LonghornEngineer/Propeller_Development_Bit_Flicker/Layout.png

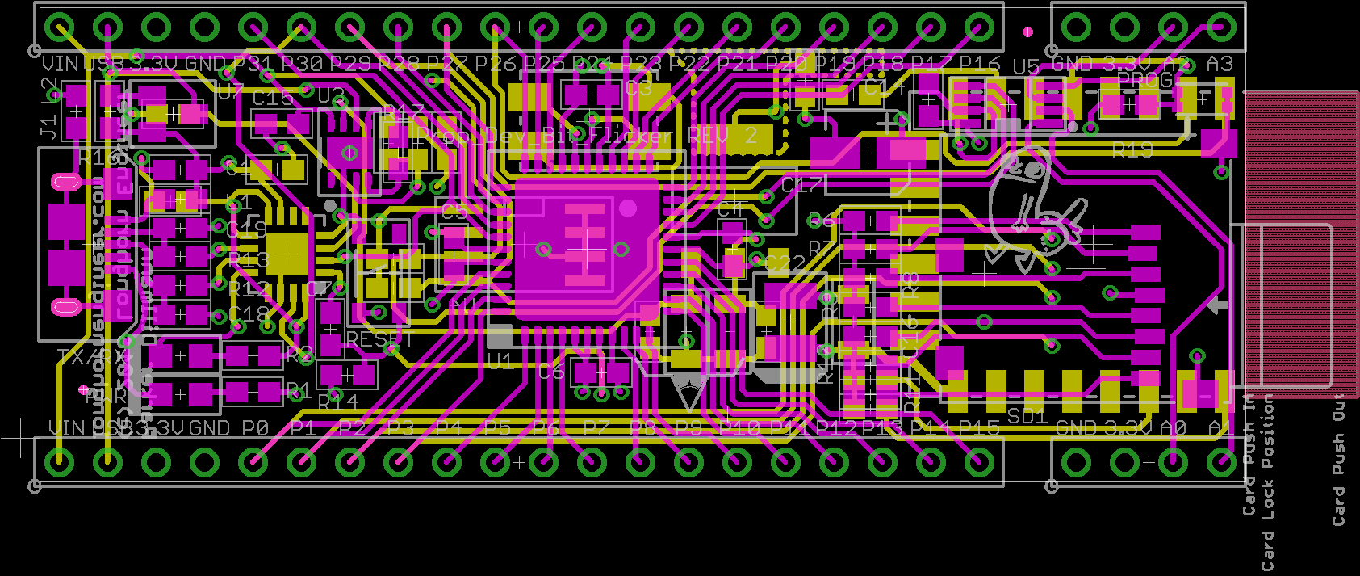
Layout.png
