LonghornEngineer/Propeller_Development_Bit_Flicker/Prop_Dev_Bit_Flicker.brd

## EAGLE design Prop_Dev_Bit_Flicker.brd (2016-04-28)

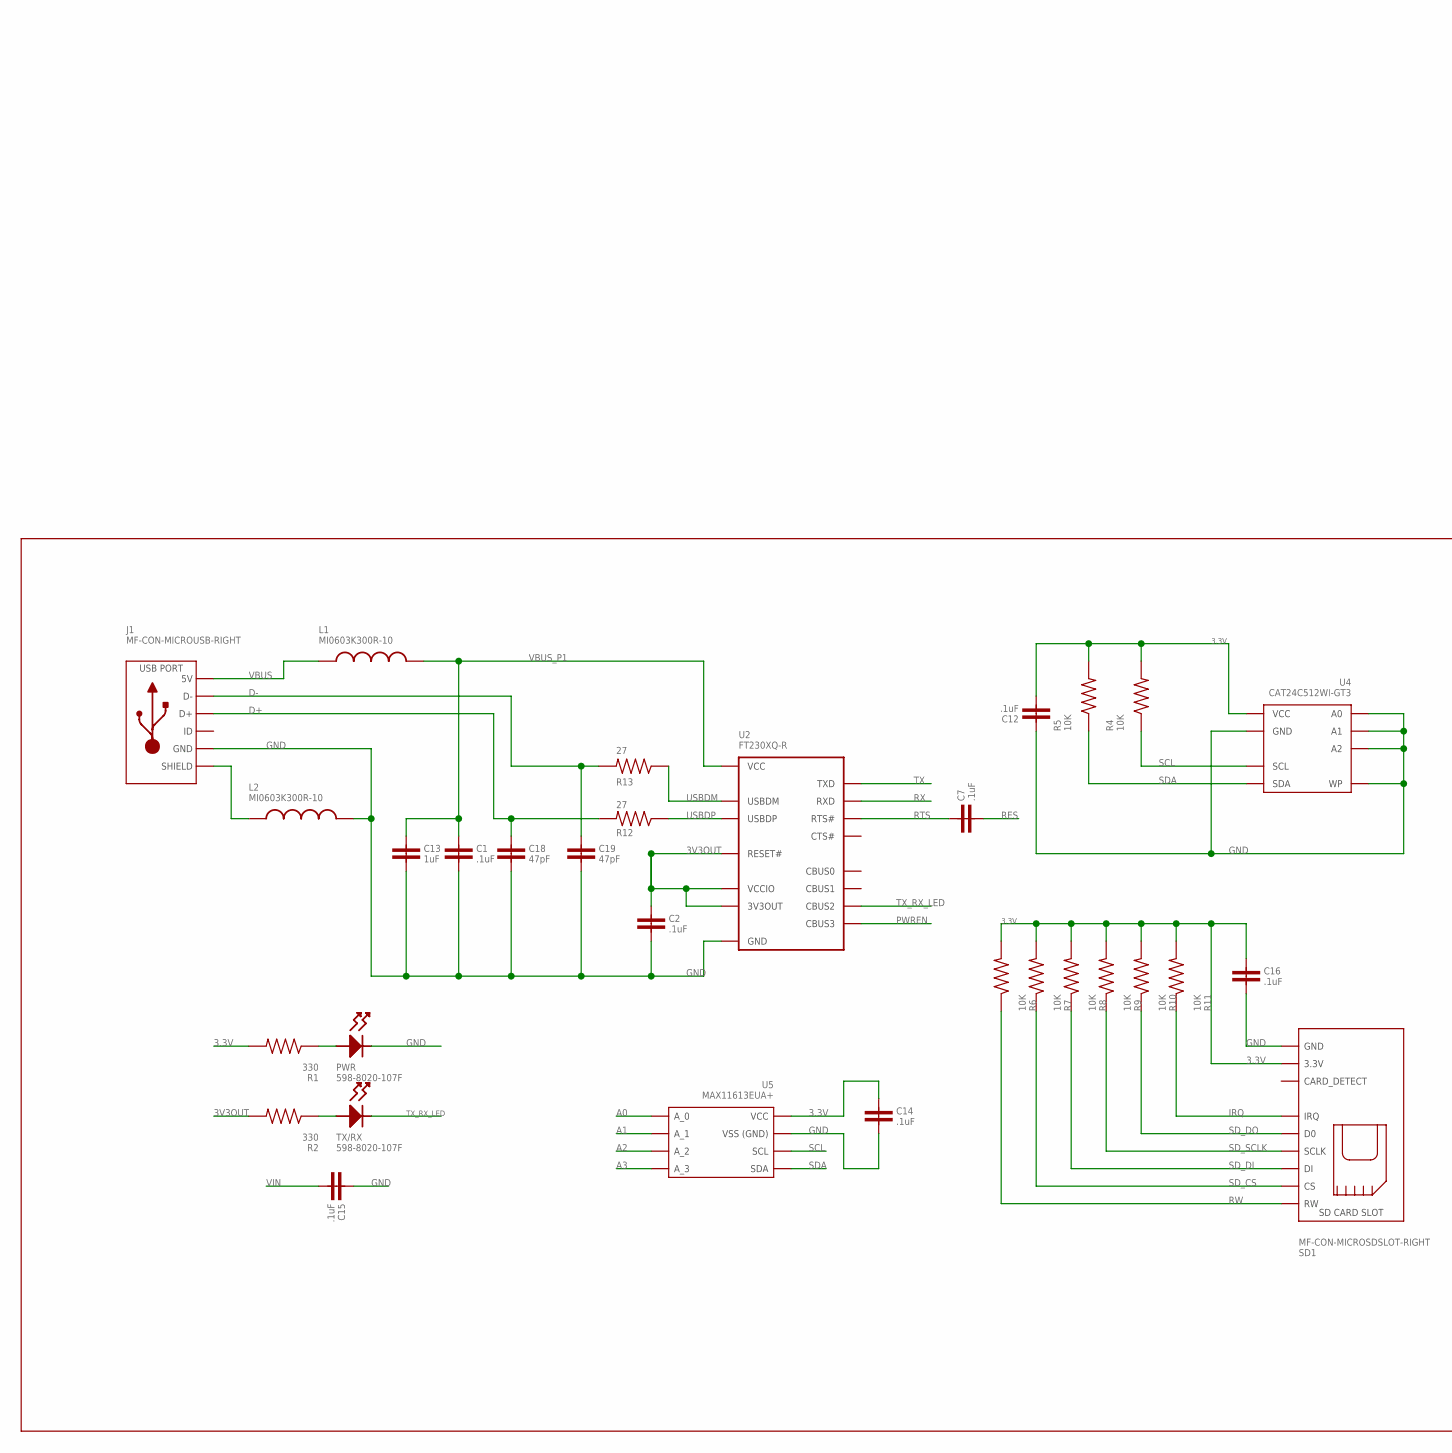
[picture p2: schematic Prop_Dev_Bit_Flicker.sch, part in row 1, column 1]

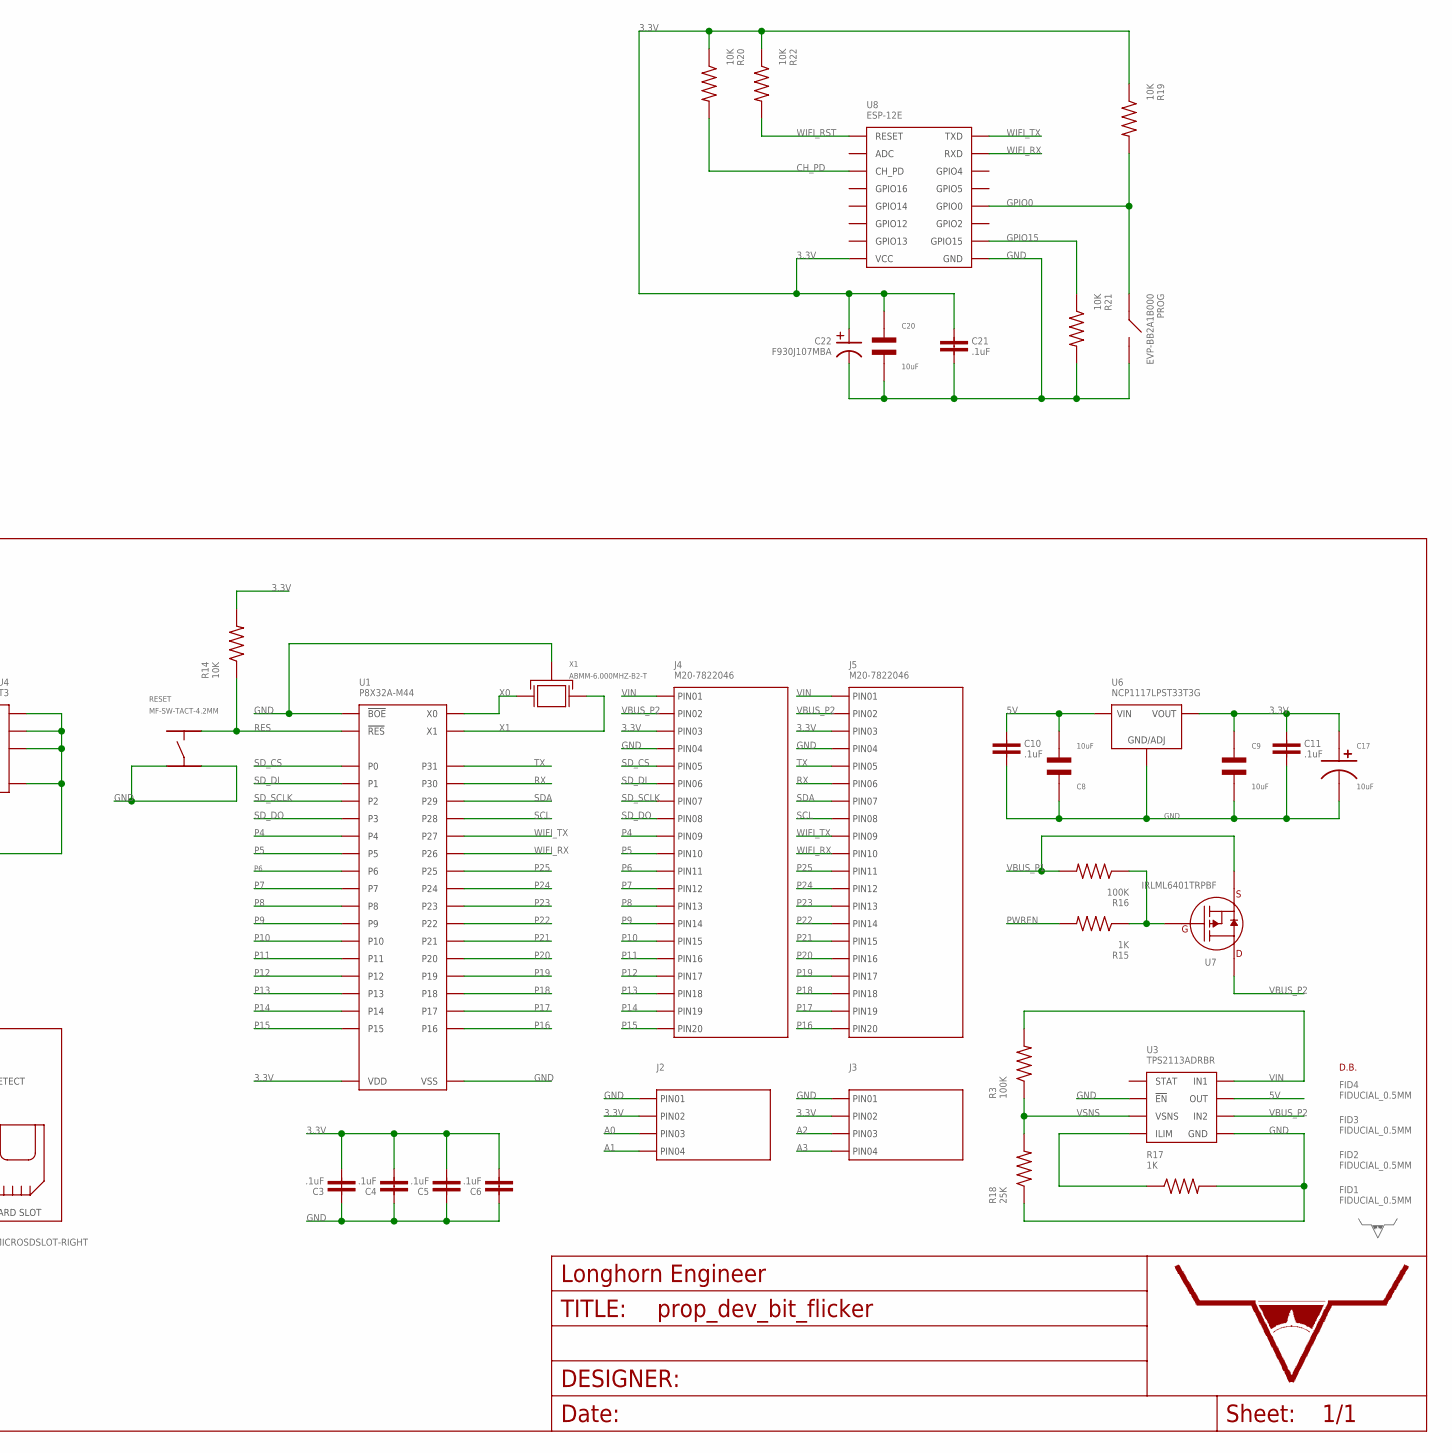
[picture p3: schematic Prop_Dev_Bit_Flicker.sch, part in row 1, column 2]

Parts:
C1, C2, C3, C4, C5, C6, C7, C10, C11, C12, C14, C15, C16, C21: .1uF; 0603
C8, C9, C20: 10uF; C1206
C13: 1uF; 0603
C17: 10uF; CP4MM
C18, C19: 47pF; 0603
C22: F930J107MBA; CASE_B
FID1, FID2, FID3, FID4: FIDUCIAL_0.5MM
J1: MF-CON-MICROUSB-RIGHT; MICROUSB-RIGHT
J2, J3: CON_01X04_2.54MM_PIN_HEADER; 2.54MM_01X04_PIN_HEADER
J4, J5: M20-7822046; 2.54MM_01X20_PIN_HEADER
L1, L2: MI0603K300R-10; 0603
PROG: EVP-BB2A1B000; EVPBB
PWR: 598-8020-107F; LED_0805
R1, R2: 330; 0603
R3, R16: 100K; 0603
R4, R5, R6, R7, R8, R9, R10, R11, R14, R19, R20, R21, R22: 10K; 0603
R12, R13: 27; 0603
R15, R17: 1K; 0603
R18: 25K; 0603
RESET: MF-SW-TACT-4.2MM; TACT4.2MM
SD1: MF-CON-MICROSDSLOT-RIGHT; MICROSDSLOT-RIGHT
TX/RX: 598-8020-107F; LED_0805
U1: P8X32A-M44; P8X32A_QFN-44
U2: FT230XQ-R; FT230X_QFN-16
U3: TPS2113ADRBR; TPS211X_SON-8
U4: CAT24C512WI-GT3; SOIC-8_W
U5: MAX11613EUA+; MAX11613_UMAX-8
U6: NCP1117LPST33T3G; SOT-223-3
U7: IRLML6401TRPBF; SOT-23-3
U8: ESP-12E
U$1: LHE_FRAME
U$2: LHE_LOGOLHE_LOGO; LHE_LOGO
U$3: DB_LOGO_SILK_SMALL; DB_SILK_SMALL
X1: ABMM-6.000MHZ-B2-T; 7MMX5MM

Connections:
3.3V: C3.2, C4.2, C5.2, C6.2, C9.P$1, C11.1, C12.2, C14.1, C16.1, C17.P$1, C20.P$1, C21.1, C22.P (POS), J2.2, J3.2, J4.3, J5.3, R1.2, R4.2, R5.2, R6.2, R7.2, R8.2, R9.2, R10.2, R11.2, R14.2, R19.1, R20.1, R22.1, SD1.PIN4 (3.3V), U1.8 (VDD), U1.18 (VDD), U1.30 (VDD), U1.40 (VDD), U4.8 (VCC), U5.P$8 (VCC), U6.P$1 (VOUT), U6.P$3 (VOUT), U8.P$8 (VCC)
3V3OUT: C2.1, R2.2, U2.1 (VCCIO), U2.8 (3V3OUT), U2.9 (RESET#)
5V: C8.P$2, C10.1, U3.7 (OUT), U6.P$4 (VIN)
A0: J2.3, U5.P$1 (A_0)
A1: J2.4, U5.P$2 (A_1)
A2: J3.3, U5.P$3 (A_2)
A3: J3.4, U5.P$4 (A_3)
CH_PD: R20.2, U8.P$3 (CH_PD)
D+: C18.1, J1.3 (D+), R12.2
D-: C19.1, J1.2 (D-), R13.2
GND: C1.2, C2.2, C3.1, C4.1, C5.1, C6.1, C8.P$1, C9.P$2, C10.2, C11.2, C12.1, C13.2, C14.2, C15.1, C16.2, C17.P$2, C18.2, C19.2, C20.P$2, C21.2, C22.N (NEG), J1.5 (GND), J2.1, J3.1, J4.4, J5.4, L2.2, PROG.P$3 (B), PROG.P$4 (B), PWR.CATHODE, R17.2, R18.1, R21.2, RESET.P$3, RESET.P$4, SD1.G0 (GND), SD1.G1 (GND), SD1.PIN6 (GND), U1.5 (VSS), U1.6 (!BOE), U1.17 (VSS), U1.27 (VSS), U1.39 (VSS), U2.3 (GND), U2.13 (GND), U2.PAD (GND), U3.2 (!EN), U3.5 (GND), U3.PAD (GND), U4.1 (A0), U4.2 (A1), U4.3 (A2), U4.4 (GND), U4.7 (WP), U5.P$7 (GND), U6.P$2 (GND/ADJ), U8.P$15 (GND), X1.P$2 (GND), X1.P$4 (GND)
GPIO0: PROG.P$1 (A), PROG.P$2 (A), R19.2, U8.P$18 (GPIO0)
GPIO15: R21.1, U8.P$16 (GPIO15)
IRQ: R11.1, SD1.PIN8 (IRQ)
unnamed: PWR.ANODE, R1.1
unnamed: R2.1, TX/RX.ANODE
unnamed: J1.S1 (SLD), J1.S2 (SLD), J1.S3 (SLD), J1.S4 (SLD), J1.S5 (SLD), J1.S6 (SLD), L2.1
unnamed: R17.1, U3.4 (ILIM)
unnamed: R15.1, R16.1, U7.1 (GATE)
P4: J4.9, U1.1 (P4)
P5: J4.10, U1.2 (P5)
P6: J4.11, U1.3 (P6)
P7: J4.12, U1.4 (P7)
P8: J4.13, U1.9 (P8)
P9: J4.14, U1.10 (P9)
P10: J4.15, U1.11 (P10)
P11: J4.16, U1.12 (P11)
P12: J4.17, U1.13 (P12)
P13: J4.18, U1.14 (P13)
P14: J4.19, U1.15 (P14)
P15: J4.20, U1.16 (P15)
P16: J5.20, U1.19 (P16)
P17: J5.19, U1.20 (P17)
P18: J5.18, U1.21 (P18)
P19: J5.17, U1.22 (P19)
P20: J5.16, U1.23 (P20)
P21: J5.15, U1.24 (P21)
P22: J5.14, U1.25 (P22)
P23: J5.13, U1.26 (P23)
P24: J5.12, U1.31 (P24)
P25: J5.11, U1.32 (P25)
PWREN: R15.2, U2.14 (CBUS3)
RES: C7.2, R14.1, RESET.P$2, U1.7 (!RES)
RTS: C7.1, U2.16 (RTS#)
RW: R6.1, SD1.PIN1 (RW)
RX: J5.6, U1.37 (P30), U2.2 (RXD)
SCL: J5.8, R4.1, U1.35 (P28), U4.6 (SCL), U5.P$5 (SCL)
SDA: J5.7, R5.1, U1.36 (P29), U4.5 (SDA), U5.P$6 (SDA)
SD_CS: J4.5, R7.1, SD1.PIN2 (CS), U1.41 (P0)
SD_DI: J4.6, R8.1, SD1.PIN3 (DI), U1.42 (P1)
SD_DO: J4.8, R10.1, SD1.PIN7 (D0), U1.44 (P3)
SD_SCLK: J4.7, R9.1, SD1.PIN5 (SCLK), U1.43 (P2)
TX: J5.5, U1.38 (P31), U2.15 (TXD)
TX_RX_LED: TX/RX.CATHODE, U2.5 (CBUS2)
USBDM: R13.1, U2.7 (USBDM)
USBDP: R12.1, U2.6 (USBDP)
VBUS: J1.1 (5V), L1.1
VBUS_P1: C1.1, C13.1, L1.2, R16.2, U2.10 (VCC), U7.2 (SOURCE)
VBUS_P2: J4.2, J5.2, U3.6 (IN2), U7.3 (DRAIN)
VIN: C15.2, J4.1, J5.1, R3.2, U3.8 (IN1)
VSNS: R3.1, R18.2, U3.3 (VSNS)
WIFI_RST: R22.2, U8.P$1 (RESET)
WIFI_RX: J5.10, U1.33 (P26), U8.P$21 (RXD)
WIFI_TX: J5.9, U1.34 (P27), U8.P$22 (TXD)
X0: U1.29 (X0), X1.P$3 (X1)
X1: U1.28 (X1), X1.P$1 (X0)

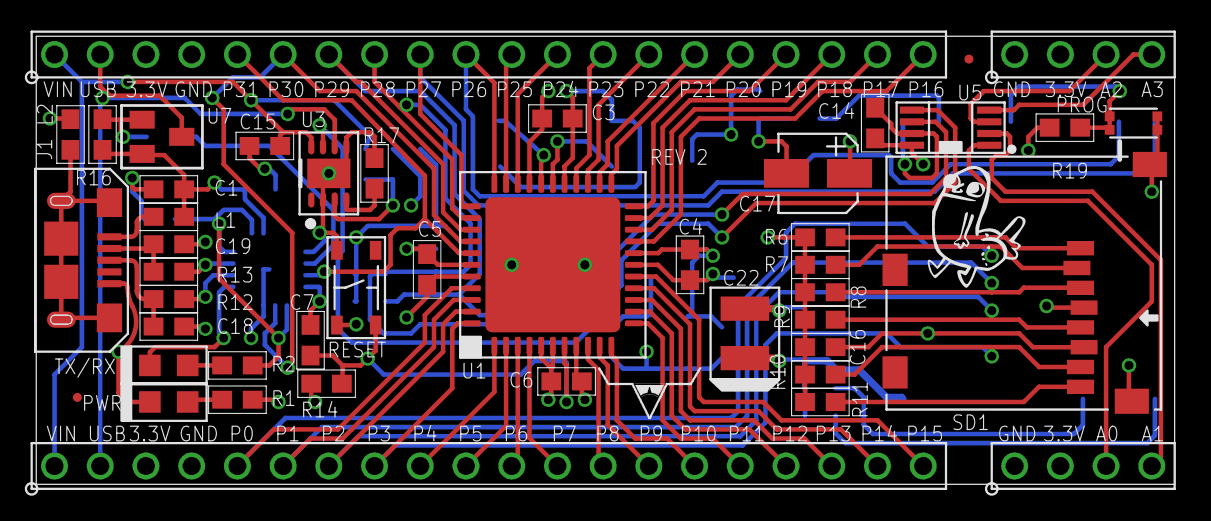
[picture p4: board Prop_Dev_Bit_Flicker.brd from above]

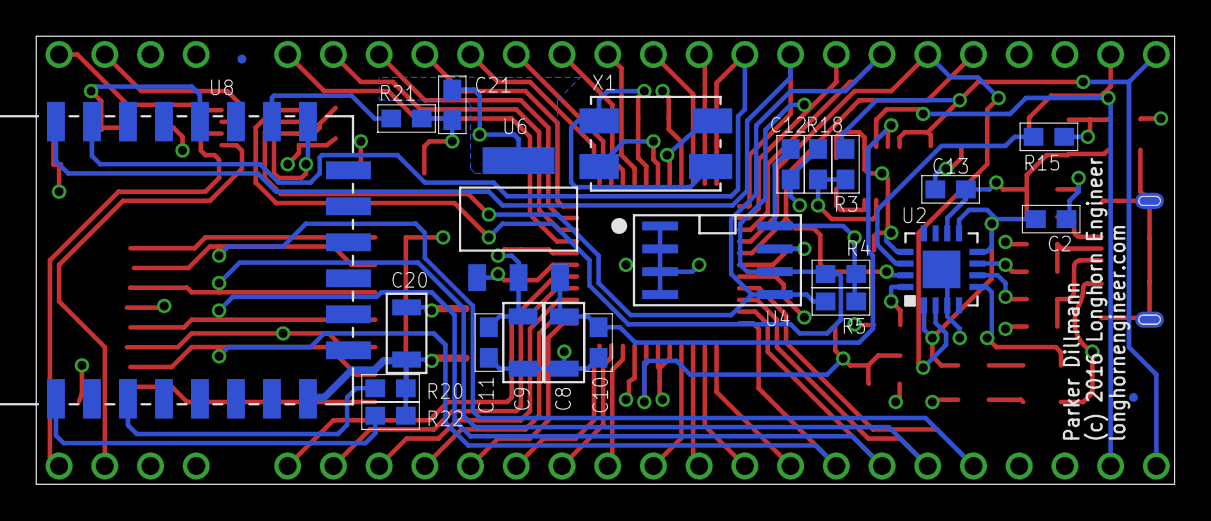
[picture p5: board Prop_Dev_Bit_Flicker.brd from below]

Board: 4 copper layers, 63.2 x 24.9 mm, 72 parts (25 on the bottom side), 66 nets.
