LonghornEngineer/Propeller_Development_Bit_Flicker/(commit log)

2016-03-22 First push of files. Schematic Finalized.
    [Prop_Dev_Bit_Flicker.brd, Prop_Dev_Bit_Flicker.sch]
2016-03-29 Working on layout.
    [Prop_Dev_Bit_Flicker.brd]
2016-04-01 preliminary layout complete.
    [Prop_Dev_Bit_Flicker.brd]
2016-04-02 top done. bottom next on silkscreen and trace clean u
    [Prop_Dev_Bit_Flicker.brd, Prop_Dev_Bit_Flicker.sch]
2016-04-04 Finished REV 2. Added Fids.
    [Prop_Dev_Bit_Flicker.GBL, Prop_Dev_Bit_Flicker.GBO, Prop_Dev_Bit_Flicker.GBP, Prop_Dev_Bit_Flicker.GBS, Prop_Dev_Bit_Flicker.GTL, Prop_Dev_Bit_Flicker.GTO, Prop_Dev_Bit_Flicker.GTP, Prop_Dev_Bit_Flicker.GTS]
2016-04-05 Added DB
    [Prop_Dev_Bit_Flicker.brd, Prop_Dev_Bit_Flicker.sch]
2016-04-05 Switch added to GPIO0 for the ESP-12E for flashing.
    [Prop_Dev_Bit_Flicker.brd, Prop_Dev_Bit_Flicker.sch]
2016-04-26 Fixed EP-12E and new camfiles.
    [Prop_Dev_Bit_Flicker.GBL, Prop_Dev_Bit_Flicker.GBO, Prop_Dev_Bit_Flicker.GBP, Prop_Dev_Bit_Flicker.GBS, Prop_Dev_Bit_Flicker.GTL, Prop_Dev_Bit_Flicker.GTO, Prop_Dev_Bit_Flicker.GTP, Prop_Dev_Bit_Flicker.GTS]
2016-04-26 Fixed part number for Prop to P8X32A-M44
    [Prop_Dev_Bit_Flicker.brd, Prop_Dev_Bit_Flicker.sch]
2016-04-28 New Camfiles and added Tant Cap 100uF to 3.3V
    [Prop_Dev_Bit_Flicker.brd, Prop_Dev_Bit_Flicker.sch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]
2016-04-28 Fixed silkscreen on top. Moved LHE Logo.
    [Prop_Dev_Bit_Flicker.brd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]
