LonghornEngineer/Propeller_Development_Bit_Flicker/(notices)

Notices in the files:
parts and their libraries:
PP_Aesthetics: (c) 2016 Longhorn Engineer
